mformore/4-20_transmitter/README.md

# 4-20mA and 0-10V Arduino Shield Transmitter
