mformore/4-20_transmitter/BOM/bom-integrated.ods

Sheet: tme
symbol klienta | Symbol | Oznaczenie producenta | Producent | Ilość | Jednostka | Cena brutto | Wartość brutto | Waluta
 | CL21C101JBANNNC | CL21C101JBANNNC | SAMSUNG | 100 | szt | 0.08288 | 8.288 | PLN
 | DG300-5.0-2P12 | DG300-5.0-02P-12-00A(H) | DEGSON ELECTRONICS | 10 | szt | 0.7287 | 7.287 | PLN
 | HP05-1K1% | HP05W3F1001T5E | ROYAL OHM | 50 | szt | 0.19454 | 9.727 | PLN
 | MCP4922-E/SL | MCP4922-E/SL | MICROCHIP TECHNOLOGY | 3 | szt | 12.3369 | 37.0107 | PLN
 | BCP5116TA | BCP5116TA | DIODES INCORPORATED | 10 | szt | 0.50355 | 5.0355 | PLN
 | BC848AE6327 | BC848AE6327 | INFINEON TECHNOLOGIES | 25 | szt | 0.107 | 2.675 | PLN
 | TL072CD | TL072CD | TEXAS INSTRUMENTS | 10 | szt | 2.4729 | 24.729 | PLN
 | BZD27C3V6P-E3-08 | BZD27C3V6P-E3-08 | VISHAY | 10 | szt | 0.59272 | 5.9272 | PLN
 | SMD2010-100R-1% | 2010W2F1000T4E | ROYAL OHM | 10 | szt | 0.46633 | 4.6633 | PLN
 | IFX91041EJV50 | IFX91041EJV50 | INFINEON TECHNOLOGIES | 3 | szt | 6.027 | 18.081 | PLN
 | DJNR5040-470-S | DJNR5040-470-S | FERROCORE | 6 | szt | 0.9232 | 5.5392 | PLN
 | 1N5333BG | 1N5333BG | ON SEMICONDUCTOR | 5 | szt | 1.0438 | 5.219 | PLN
 | 11-21SURC/S530-A2 | 11-21SURC/S530-A2/TR8 | EVERLIGHT | 10 | szt | 0.58747 | 5.8747 | PLN
 | 15-21UYC/S530-A2 | 15-21UYC/S530-A2/TR8 | EVERLIGHT | 10 | szt | 0.6819 | 6.819 | PLN
 | CL21B224KBFNNNE | CL21B224KBFNNNE | SAMSUNG | 100 | szt | 0.08918 | 8.918 | PLN
 | SMD0805-22K-1% | 0805S8F2202T5E | ROYAL OHM | 100 | szt | 0.07721 | 7.721 | PLN
 | IFX91041EJV33 | IFX91041EJV33XUMA1 | INFINEON TECHNOLOGIES | 2 | szt | 5.0307 | 10.0614 | PLN
 | SC1H106M6L005VR | SC1H106M6L005VR | SAMWHA | 25 | szt | 0.30738 | 7.6845 | PLN
 | SC1C107M6L005VR | SC1C107M6L005VR | SAMWHA | 25 | szt | 0.17467 | 4.36675 | PLN
 | SYS1530-1224-W2E | SYS1530-1224-W2E | SUNNY | 1 | szt | 36.9 | 36.9 | PLN
 | NEB21R | NEB 21 R | LUMBERG | 1 | szt | 2.597 | 2.597 | PLN
 | SMD0805-2K2-1% | 0805S8F2201T5E | ROYAL OHM | 100 | szt | 0.07721 | 7.721 | PLN
 | T910W-2K | T910W-2K | SR PASSIVES | 10 | szt | 1.4932 | 14.932 | PLN
 | CL21B104KBCNNNC | CL21B104KBCNNNC | SAMSUNG | 100 | szt | 0.08392 | 8.392 | PLN
 | AL1A-DIO | AL1A | DIOTEC SEMICONDUCTOR | 5 | szt | 0.61895 | 3.09475 | PLN
 | BZX384-B4V7.115 | BZX384-B4V7.115 | NEXPERIA | 20 | szt | 0.1542 | 3.084 | PLN
 | MOF1WS-100K | MOF1WS-100K | SR PASSIVES | 20 | szt | 0.17899 | 3.5798 | PLN
 | RC0805JR-0710K | RC0805JR-0710KL | YAGEO | 100 | szt | 0.0577 | 5.77 | PLN
 | SMD0805-3K | 0805S8J0302T5E | ROYAL OHM | 100 | szt | 0.0683 | 6.83 | PLN
 | SMD0805-1K | 0805S8J0102T5E | ROYAL OHM | 100 | szt | 0.06735 | 6.735 | PLN
 | CRCW080510K0FKTABC | CRCW080510K0FKTABC | VISHAY | 100 | szt | 0.06871 | 6.871 | PLN
 | SMD1206-100K | 1206S4J0104T5E | ROYAL OHM | 100 | szt | 0.06547 | 6.547 | PLN
 | 1SMB5913BT3G | 1SMB5913BT3G | ON SEMICONDUCTOR | 5 | szt | 0.5702 | 2.851 | PLN
 | SS16A-YAN | SS16A | YANGJIE TECHNOLOGY | 20 | szt | 0.14366 | 2.8732 | PLN
 | SMD0805-9K1-1% | 0805S8F9101T5E | ROYAL OHM | 100 | szt | 0.0424 | 4.24 | PLN
 | CL21B223KBANNNC | CL21B223KBANNNC | SAMSUNG | 100 | szt | 0.08341 | 8.341 | PLN

Sheet: kicad
Source: | /home/maciej/Desktop/420-transmitter/420-transmitter/PCB/420-transmitter/420-transmitter.sch
Date: | pon, 29 lip 2019, 13:12:20
Tool: | Eeschema 5.1.2-f72e74a~84~ubuntu19.04.1
Generator: | /usr/share/kicad/plugins/bom_csv_grouped_by_value_with_fp.py
Component Count: | 112
Ref | Qnty | Value | Cmp name | Footprint | Description | Vendor | Part number
C2, | 1 | 10u | CP | Capacitor_SMD:CP_Elec_6.3x5.3 | Polarized capacitor |  | SC1H106M6L005VR
C4, C5, C10, C3, C1, C11, C9, | 7 | 100n | C | Capacitor_SMD:C_0805_2012Metric | Unpolarized capacitor |  | CL21B104KBCNNNC
C6, | 1 | 22n | C | Capacitor_SMD:C_0805_2012Metric | Unpolarized capacitor |  | CL21B223KBANNNC
C7, C12, | 2 | 220nF | C | Capacitor_SMD:C_0805_2012Metric | Unpolarized capacitor |  | CL21B224KBFNNNE
C8, | 1 | 100uF | CP | Capacitor_SMD:CP_Elec_6.3x5.3 | Polarized capacitor |  | SC1C107M6L005VR
C13, C15, C14, C16, | 4 | 100p | C | Capacitor_SMD:C_0805_2012Metric | Unpolarized capacitor |  | CL21C101JBANNNC
D1, D3, | 2 | AL1A | D | Diode_SMD:D_MiniMELF | Diode |  | AL1A
D2, | 1 | 1SMB5913BT3G | D_Zener | Diode_SMD:D_SMB | Zener diode |  | 1SMB5913BT3G
D4, | 1 | SS16A | D_Schottky | Diode_SMD:D_SMA | Schottky diode |  | SS16A
D6, D5, | 2 | BZD27C3V6P-E3-08 | D_Zener | Diode_SMD:D_SOD-123 | Zener diode |  | BZD27C3V6P-E3-08
D7, D8, | 2 | BZX384-B4V7.115 | BZX384-B4V7.115-Diode_custom-420-transmitter-rescue | Diode_SMD:D_SOD-323 |  |  | BZX384-B4V7.115
H1, H5, H7, H2, H4, H6, H8, H9, H3, | 9 | TP1 | MountingHole_Pad | TestPoint:TestPoint_THTPad_D1.0mm_Drill0.5mm | Mounting Hole with connection |  | -
J1, J5, | 2 | Conn_01x08 | Conn_01x08 | Connector_PinSocket_2.54mm:PinSocket_1x08_P2.54mm_Vertical | Generic connector, single row, 01x08, script generated (kicad-library-utils/schlib/autogen/connector/) |  | -
J2, | 1 | Conn_01x06 | Conn_01x06 | m_connectors:PinSocket_1x06_P2.54mm_Vertical_w_Arduino | Generic connector, single row, 01x06, script generated (kicad-library-utils/schlib/autogen/connector/) |  | -
J4, | 1 | Conn_01x10 | Conn_01x10 | Connector_PinSocket_2.54mm:PinSocket_1x10_P2.54mm_Vertical | Generic connector, single row, 01x10, script generated (kicad-library-utils/schlib/autogen/connector/) |  | -
J6, | 1 | 4-20mA_loop1 | Screw_Terminal_01x02 | m_connectors:TerminalBlock_bornier-2_P5.08mm | Generic screw terminal, single row, 01x02, script generated (kicad-library-utils/schlib/autogen/connector/) |  | DG300-5.0-02P-12-00A(H)
J7, | 1 | 4-20mA_loop2 | Screw_Terminal_01x02 | m_connectors:TerminalBlock_bornier-2_P5.08mm | Generic screw terminal, single row, 01x02, script generated (kicad-library-utils/schlib/autogen/connector/) |  | DG300-5.0-02P-12-00A(H)
J8, | 1 | 0-10V_Vout1 | Screw_Terminal_01x02 | m_connectors:TerminalBlock_bornier-2_P5.08mm | Generic screw terminal, single row, 01x02, script generated (kicad-library-utils/schlib/autogen/connector/) |  | DG300-5.0-02P-12-00A(H)
J9, | 1 | 0-10V_Vout2 | Screw_Terminal_01x02 | m_connectors:TerminalBlock_bornier-2_P5.08mm | Generic screw terminal, single row, 01x02, script generated (kicad-library-utils/schlib/autogen/connector/) |  | DG300-5.0-02P-12-00A(H)
J10, | 1 | PWR SW | Conn_01x02 | Connector_PinHeader_2.54mm:PinHeader_1x02_P2.54mm_Vertical | Generic connector, single row, 01x02, script generated (kicad-library-utils/schlib/autogen/connector/) |  | -
J33, | 1 | Barrel_Jack_MountingPin | Barrel_Jack_MountingPin | m_connectors:BarrelJack_Wuerth_6941xx301002 | DC Barrel Jack with a mounting pin |  | NEB 21 R
JP1, | 1 | Vin1 | Jumper_NC_Dual | Connector_PinHeader_2.54mm:PinHeader_1x03_P2.54mm_Vertical | Dual jumper, normally closed |  | -
JP2, | 1 | Vin2 | Jumper_NC_Dual | Connector_PinHeader_2.54mm:PinHeader_1x03_P2.54mm_Vertical | Dual jumper, normally closed |  | -
L1, L2, | 2 | 47uH | L | Inductor_SMD:L_Taiyo-Yuden_MD-5050 | Inductor |  | DJNR5040-470-S
LED_Vin1, LED_Vin2, PWR2, PWR1, | 4 | LED | LED | LED_SMD:LED_0805_2012Metric | Light emitting diode |  | 15-21UYC/S530-A2/TR8
Q4, Q2, Q1, Q3, | 4 | BC848AE | BC848 | Package_TO_SOT_SMD:SOT-23 | 0.1A Ic, 30V Vce, NPN Transistor, SOT-23 |  | BC848AE6327
Q5, Q6, | 2 | BCP5116TA | Q_PNP_BCEC | Package_TO_SOT_SMD:SOT-223 | PNP transistor, base/collector/emitter, collector connected to mounting plane |  | BCP5116TA
R1, | 1 | 100k | R | Resistor_SMD:R_1206_3216Metric | Resistor |  | 1206S4J0104T5E
R3, | 1 | 3k | R | Resistor_SMD:R_0805_2012Metric | Resistor |  | 0805S8J0302T5E
R4, R5, R6, R46, | 4 | 1k | R | Resistor_SMD:R_0805_2012Metric | Resistor |  | 0805S8J0102T5E
R7, | 1 | 22k | R | Resistor_SMD:R_0805_2012Metric | Resistor |  | 0805S8F2202T5E
R8, R9, | 2 | 100 | R | Resistor_SMD:R_0805_2012Metric | Resistor |  | 2010W2F1000T4E
R12, R22, R10, R13, R23, R11, R2, | 7 | 10k | R | Resistor_SMD:R_0805_2012Metric | Resistor |  | RC0805JR-0710KL
R14, R28, R26, R16, R29, R27, | 6 | 1k 1% | R | Resistor_SMD:R_0805_2012Metric | Resistor |  | 0805S8F9101T5E
R15, R17, | 2 | 2,2k 1% | R | Resistor_SMD:R_0805_2012Metric | Resistor |  | 0805S8F2201T5E
R18, R19, | 2 | 10k 1% | R | Resistor_SMD:R_0805_2012Metric | Resistor |  | CRCW080510K0FKTABC
R20, R21, | 2 | 9,1k 1% | R | Resistor_SMD:R_0805_2012Metric | Resistor |  | 0805S8F9101T5E
R24, R25, | 2 | 100 1% | R | Resistor_SMD:R_2010_5025Metric | Resistor |  | 2010W2F1000T4E
R30, R32, R31, R33, R34, R36, R35, R37, R40, R38, R41, R39, R44, R42, R45, R43, | 16 | adj | R | Resistor_SMD:R_0805_2012Metric | Resistor |  | -
RV3, RV1, RV2, RV4, | 4 | 2k | R_POT_TRIM | Potentiometer_THT:Potentiometer_Bourns_3296W_Vertical | Trim-potentiometer |  | T910W-2K
U2, U4, U5, | 3 | TL072 | TL072 | Package_SO:SO-8_5.3x6.2mm_P1.27mm | Dual Low-Noise JFET-Input Operational Amplifiers, DIP-8/SOIC-8 |  | TL072CD
U3, | 1 | MCP4922 | MCP4922 | m_integrated_circuits:SO14 | 2-Channel 12-Bit D/A Converters with SPI Interface |  | MCP4922-E/SL
U6, | 1 | IFX91041EJV50 | IFX91041EJV50 | m_integrated_circuits:Infineon_PG-DSO-8-43 |  |  | IFX91041EJV50

Sheet: integrated
Ref | Qnty | Value | Cmp name | Footprint | Description | Vendor | Part number | Cost
C2, | 1 | 10u | CP | Capacitor_SMD:CP_Elec_6.3x5.3 | Polarized capacitor |  | SC1H106M6L005VR | 0.30738
C4, C5, C10, C3, C1, C11, C9, | 7 | 100n | C | Capacitor_SMD:C_0805_2012Metric | Unpolarized capacitor |  | CL21B104KBCNNNC | 0.58744
C6, | 1 | 22n | C | Capacitor_SMD:C_0805_2012Metric | Unpolarized capacitor |  | CL21B223KBANNNC | 0.08341 |  |  | sum= | 51.76532
C7, C12, | 2 | 220nF | C | Capacitor_SMD:C_0805_2012Metric | Unpolarized capacitor |  | CL21B224KBFNNNE | 0.17836
C8, | 1 | 100uF | CP | Capacitor_SMD:CP_Elec_6.3x5.3 | Polarized capacitor |  | SC1C107M6L005VR | 0.17467
C13, C15, C14, C16, | 4 | 100p | C | Capacitor_SMD:C_0805_2012Metric | Unpolarized capacitor |  | CL21C101JBANNNC | 0.33152
D1, D3, | 2 | AL1A | D | Diode_SMD:D_MiniMELF | Diode |  | AL1A | 1.2379
D2, | 1 | 1SMB5913BT3G | D_Zener | Diode_SMD:D_SMB | Zener diode |  | 1SMB5913BT3G | 0.5702
D4, | 1 | SS16A | D_Schottky | Diode_SMD:D_SMA | Schottky diode |  | SS16A | 0.14366
D6, D5, | 2 | BZD27C3V6P-E3-08 | D_Zener | Diode_SMD:D_SOD-123 | Zener diode |  | BZD27C3V6P-E3-08 | 1.18544 | replacement: | ON SEMICONDUCTOR MMSZ5227BT1G
D7, D8, | 2 | BZX384-B4V7.115 | BZX384-B4V7.115-Diode_custom-420-transmitter-rescue | Diode_SMD:D_SOD-323 |  |  | BZX384-B4V7.115 | 0.3084
H1, H5, H7, H2, H4, H6, H8, H9, H3, | 9 | TP1 | MountingHole_Pad | TestPoint:TestPoint_THTPad_D1.0mm_Drill0.5mm | Mounting Hole with connection |  | - | 0
J1, J5, | 2 | Conn_01x08 | Conn_01x08 | Connector_PinSocket_2.54mm:PinSocket_1x08_P2.54mm_Vertical | Generic connector, single row, 01x08, script generated (kicad-library-utils/schlib/autogen/connector/) |  | - | 0
J2, | 1 | Conn_01x06 | Conn_01x06 | m_connectors:PinSocket_1x06_P2.54mm_Vertical_w_Arduino | Generic connector, single row, 01x06, script generated (kicad-library-utils/schlib/autogen/connector/) |  | - | 0
J4, | 1 | Conn_01x10 | Conn_01x10 | Connector_PinSocket_2.54mm:PinSocket_1x10_P2.54mm_Vertical | Generic connector, single row, 01x10, script generated (kicad-library-utils/schlib/autogen/connector/) |  | - | 0
J6, | 1 | 4-20mA_loop1 | Screw_Terminal_01x02 | m_connectors:TerminalBlock_bornier-2_P5.08mm | Generic screw terminal, single row, 01x02, script generated (kicad-library-utils/schlib/autogen/connector/) |  | DG300-5.0-02P-12-00A(H) | 0.7287
J7, | 1 | 4-20mA_loop2 | Screw_Terminal_01x02 | m_connectors:TerminalBlock_bornier-2_P5.08mm | Generic screw terminal, single row, 01x02, script generated (kicad-library-utils/schlib/autogen/connector/) |  | DG300-5.0-02P-12-00A(H) | 0.7287
J8, | 1 | 0-10V_Vout1 | Screw_Terminal_01x02 | m_connectors:TerminalBlock_bornier-2_P5.08mm | Generic screw terminal, single row, 01x02, script generated (kicad-library-utils/schlib/autogen/connector/) |  | DG300-5.0-02P-12-00A(H) | 0.7287
J9, | 1 | 0-10V_Vout2 | Screw_Terminal_01x02 | m_connectors:TerminalBlock_bornier-2_P5.08mm | Generic screw terminal, single row, 01x02, script generated (kicad-library-utils/schlib/autogen/connector/) |  | DG300-5.0-02P-12-00A(H) | 0.7287
J10, | 1 | PWR SW | Conn_01x02 | Connector_PinHeader_2.54mm:PinHeader_1x02_P2.54mm_Vertical | Generic connector, single row, 01x02, script generated (kicad-library-utils/schlib/autogen/connector/) |  | - | 0
J33, | 1 | Barrel_Jack_MountingPin | Barrel_Jack_MountingPin | m_connectors:BarrelJack_Wuerth_6941xx301002 | DC Barrel Jack with a mounting pin |  | NEB 21 R | 2.597
JP1, | 1 | Vin1 | Jumper_NC_Dual | Connector_PinHeader_2.54mm:PinHeader_1x03_P2.54mm_Vertical | Dual jumper, normally closed |  | - | 0
JP2, | 1 | Vin2 | Jumper_NC_Dual | Connector_PinHeader_2.54mm:PinHeader_1x03_P2.54mm_Vertical | Dual jumper, normally closed |  | - | 0
L1, L2, | 2 | 47uH | L | Inductor_SMD:L_Taiyo-Yuden_MD-5050 | Inductor |  | DJNR5040-470-S | 1.8464
LED_Vin1, LED_Vin2, PWR2, PWR1, | 4 | LED | LED | LED_SMD:LED_0805_2012Metric | Light emitting diode |  | 15-21UYC/S530-A2/TR8 | 2.7276
Q4, Q2, Q1, Q3, | 4 | BC848AE | BC848 | Package_TO_SOT_SMD:SOT-23 | 0.1A Ic, 30V Vce, NPN Transistor, SOT-23 |  | BC848AE6327 | 0.428
Q5, Q6, | 2 | BCP5116TA | Q_PNP_BCEC | Package_TO_SOT_SMD:SOT-223 | PNP transistor, base/collector/emitter, collector connected to mounting plane |  | BCP5116TA | 1.0071
R1, | 1 | 100k | R | Resistor_SMD:R_1206_3216Metric | Resistor |  | 1206S4J0104T5E | 0.06547
R3, | 1 | 3k | R | Resistor_SMD:R_0805_2012Metric | Resistor |  | 0805S8J0302T5E | 0.0683
R4, R5, R6, R46, | 4 | 1k | R | Resistor_SMD:R_0805_2012Metric | Resistor |  | 0805S8J0102T5E | 0.2694
R7, | 1 | 22k | R | Resistor_SMD:R_0805_2012Metric | Resistor |  | 0805S8F2202T5E | 0.07721
R8, R9, | 2 | 100 | R | Resistor_SMD:R_0805_2012Metric | Resistor |  | 2010W2F1000T4E | 0.93266
R12, R22, R10, R13, R23, R11, R2, | 7 | 10k | R | Resistor_SMD:R_0805_2012Metric | Resistor |  | RC0805JR-0710KL | 0.4039
R14, R28, R26, R16, R29, R27, | 6 | 1k 1% | R | Resistor_SMD:R_0805_2012Metric | Resistor |  | 0805S8F9101T5E | 0.2544
R15, R17, | 2 | 2,2k 1% | R | Resistor_SMD:R_0805_2012Metric | Resistor |  | 0805S8F2201T5E | 0.15442
R18, R19, | 2 | 10k 1% | R | Resistor_SMD:R_0805_2012Metric | Resistor |  | CRCW080510K0FKTABC | 0.13742
R20, R21, | 2 | 9,1k 1% | R | Resistor_SMD:R_0805_2012Metric | Resistor |  | 0805S8F9101T5E | 0.0848
R24, R25, | 2 | 100 1% | R | Resistor_SMD:R_2010_5025Metric | Resistor |  | 2010W2F1000T4E | 0.93266
R30, R32, R31, R33, R34, R36, R35, R37, R40, R38, R41, R39, R44, R42, R45, R43, | 16 | adj | R | Resistor_SMD:R_0805_2012Metric | Resistor |  | - | 0
RV3, RV1, RV2, RV4, | 4 | 2k | R_POT_TRIM | Potentiometer_THT:Potentiometer_Bourns_3296W_Vertical | Trim-potentiometer |  | T910W-2K | 5.9728
U2, U4, U5, | 3 | TL072 | TL072 | Package_SO:SO-8_5.3x6.2mm_P1.27mm | Dual Low-Noise JFET-Input Operational Amplifiers, DIP-8/SOIC-8 |  | TL072CD | 7.4187
U3, | 1 | MCP4922 | MCP4922 | m_integrated_circuits:SO14 | 2-Channel 12-Bit D/A Converters with SPI Interface |  | MCP4922-E/SL | 12.3369
U6, | 1 | IFX91041EJV50 | IFX91041EJV50 | m_integrated_circuits:Infineon_PG-DSO-8-43 |  |  | IFX91041EJV50 | 6.027

Sheet: Dokumentacja
Symbol | Ilość | Wartość | Obudowa | Opis | Numer części (TME) | Koszt
C2, | 1 | 10u | 6.3x5.3mm | Kondensator ceramiczny | SC1H106M6L005VR | 0.30738
C4, C5, C10, C3, C1, C11, C9, | 7 | 100n | 0805 | Kondensator ceramiczny | CL21B104KBCNNNC | 0.58744
C6, | 1 | 22n | 0805 | Kondensator ceramiczny | CL21B223KBANNNC | 0.08341 |  |  | sum= | 51.76532
C7, C12, | 2 | 220nF | 0805 | Kondensator ceramiczny | CL21B224KBFNNNE | 0.17836
C8, | 1 | 100uF | 6.3x5.3mm | Kondensator elektrolityczny | SC1C107M6L005VR | 0.17467
C13, C15, C14, C16, | 4 | 100p | 0805 | Kondensator ceramiczny | CL21C101JBANNNC | 0.33152
D1, D3, | 2 | 1A; max 50V | MiniMELF | Dioda prostownicza | AL1A | 1.2379
D2, | 1 | 3,3V | SMB | Dioda Zenera | 1SMB5913BT3G | 0.5702
D4, | 1 | 60V | SMA | Dioda Schottky’ego | SS16A | 0.14366
D6, D5, | 2 | 3,6V | SOD-123 | Dioda Zenera | BZD27C3V6P-E3-08 | 1.18544 | replacement: | ON SEMICONDUCTOR MMSZ5227BT1G
D7, D8, | 2 | 4,7V | SOD-323 | Dioda Zenera | BZX384-B4V7.115 | 0.3084
J1, J5, | 2 | - | Raster 2,54mm 1x8 | Listwa goldpin żeńska | - | 0
J2, | 1 | - | Raster 2,54mm 1x6 | Listwa goldpin żeńska | - | 0
J4, | 1 | - | Raster 2,54mm 1x10 | Listwa goldpin żeńska | - | 0
J6, | 1 | - | Raster 5.08mm x2 | Złącze zaciskowe | DG300-5.0-02P-12-00A(H) | 0.7287
J7, | 1 | - | Raster 5.08mm 1x2 | Złącze zaciskowe | DG300-5.0-02P-12-00A(H) | 0.7287
J8, | 1 | - | Raster 5.08mm 1x2 | Złącze zaciskowe | DG300-5.0-02P-12-00A(H) | 0.7287
J9, | 1 | - | Raster 5.08mm 1x2 | Złącze zaciskowe | DG300-5.0-02P-12-00A(H) | 0.7287
J10, | 1 | - | Raster 2,54mm 1x2 | Listwa goldpin męska | - | 0
J33, | 1 | - | Wuerth_6941xx301002 | Gniazdo DC okrągłe | NEB 21 R | 2.597
JP1, | 1 | - | Raster 2,54mm 1x3 | Listwa goldpin męska | - | 0
JP2, | 1 | - | Raster 2,54mm 1x3 | Listwa goldpin męska | - | 0
L1, L2, | 2 | 47uH | Taiyo-Yuden_MD-5050 | Cewka | DJNR5040-470-S | 1.8464
LED_Vin1, LED_Vin2, PWR2, PWR1, | 4 | - | 1206 | LED | 15-21UYC/S530-A2/TR8 | 2.7276
Q4, Q2, Q1, Q3, | 4 | 30V; 0,1A; 0,3W | SOT-23 | Tranzystor NPN | BC848AE6327 | 0.428
Q5, Q6, | 2 | 45V; 1A; 2W | SOT-223 | Tranzystor PNP | BCP5116TA | 1.0071
R1, | 1 | 100k | 1206 | Rezystor | 1206S4J0104T5E | 0.06547
R3, | 1 | 3k | 0805 | Rezystor | 0805S8J0302T5E | 0.0683
R4, R5, R6, R46, | 4 | 1k | 0805 | Rezystor | 0805S8J0102T5E | 0.2694
R7, | 1 | 22k | 0805 | Rezystor | 0805S8F2202T5E | 0.07721
R8, R9, | 2 | 100 | 0805 | Rezystor | 2010W2F1000T4E | 0.93266
R12, R22, R10, R13, R23, R11, R2, | 7 | 10k | 0805 | Rezystor | RC0805JR-0710KL | 0.4039
R14, R28, R26, R16, R29, R27, | 6 | 1k 1% | 0805 | Rezystor | 0805S8F9101T5E | 0.2544
R15, R17, | 2 | 2,2k 1% | 0805 | Rezystor | 0805S8F2201T5E | 0.15442
R18, R19, | 2 | 10k 1% | 0805 | Rezystor | CRCW080510K0FKTABC | 0.13742
R20, R21, | 2 | 9,1k 1% | 0805 | Rezystor | 0805S8F9101T5E | 0.0848
R24, R25, | 2 | 100 1% | 2010 | Rezystor | 2010W2F1000T4E | 0.93266
RV3, RV1, RV2, RV4, | 4 | 2k | Bourns_3296W_Vertical | Potencjometr montażowy | T910W-2K | 5.9728
U2, U4, U5, | 3 | -15/+15V | DIP-8/SOIC-8 | Wzmacniacz operacyjny | TL072CD | 7.4187
U3, | 1 | 14bit; SPI | SO14 | Przetwornik DAC | MCP4922-E/SL | 12.3369
U6, | 1 | +5V; 1,8A | Infineon_PG-DSO-8-43 | Przetwornica step-down | IFX91041EJV50 | 6.027
 | 75

Sheet: pivot-table
l.p. | Symbol | Oznaczenie producenta | Producent | Ilość | Jednostka | Cena brutto | Wartość brutto | Waluta | (empty)
1 | CL21C101JBANNNC | CL21C101JBANNNC | SAMSUNG | 100 | szt | 0.08288 | 8.288 | PLN
2 | C0805C223K5RACAUTO | C0805C223K5RACAUTO | KEMET | 10 | szt | 0.29216 | 2.9216 | PLN
3 | DG300-5.0-2P12 | DG300-5.0-02P-12-00A(H) | DEGSON ELECTRONICS | 10 | szt | 0.7287 | 7.287 | PLN
4 | HP05-1K1% | HP05W3F1001T5E | ROYAL OHM | 50 | szt | 0.19454 | 9.727 | PLN
5 | MCP4922-E/SL | MCP4922-E/SL | MICROCHIP TECHNOLOGY | 3 | szt | 12.3369 | 37.0107 | PLN
6 | BCP5116TA | BCP5116TA | DIODES INCORPORATED | 10 | szt | 0.50355 | 5.0355 | PLN
7 | BC848AE6327 | BC848AE6327 | INFINEON TECHNOLOGIES | 25 | szt | 0.107 | 2.675 | PLN
8 | TL072CD | TL072CD | TEXAS INSTRUMENTS | 10 | szt | 2.4729 | 24.729 | PLN
9 | BZD27C3V6P-E3-08 | BZD27C3V6P-E3-08 | VISHAY | 10 | szt | 0.59272 | 5.9272 | PLN
10 | SMD2010-100R-1% | 2010W2F1000T4E | ROYAL OHM | 10 | szt | 0.46633 | 4.6633 | PLN
11 | IFX91041EJV50 | IFX91041EJV50 | INFINEON TECHNOLOGIES | 3 | szt | 6.027 | 18.081 | PLN
12 | DJNR5040-470-S | DJNR5040-470-S | FERROCORE | 6 | szt | 0.9232 | 5.5392 | PLN
13 | 1N5333BG | 1N5333BG | ON SEMICONDUCTOR | 5 | szt | 1.0438 | 5.219 | PLN
14 | 11-21SURC/S530-A2 | 11-21SURC/S530-A2/TR8 | EVERLIGHT | 10 | szt | 0.58747 | 5.8747 | PLN
15 | 15-21UYC/S530-A2 | 15-21UYC/S530-A2/TR8 | EVERLIGHT | 10 | szt | 0.6819 | 6.819 | PLN
16 | CL21B224KBFNNNE | CL21B224KBFNNNE | SAMSUNG | 100 | szt | 0.08918 | 8.918 | PLN
17 | SMD0805-22K-1% | 0805S8F2202T5E | ROYAL OHM | 100 | szt | 0.07721 | 7.721 | PLN
18 | IFX91041EJV33 | IFX91041EJV33XUMA1 | INFINEON TECHNOLOGIES | 2 | szt | 5.0307 | 10.0614 | PLN
19 | SC1H106M6L005VR | SC1H106M6L005VR | SAMWHA | 25 | szt | 0.30738 | 7.6845 | PLN
20 | SC1C107M6L005VR | SC1C107M6L005VR | SAMWHA | 25 | szt | 0.17467 | 4.36675 | PLN
21 | SYS1530-1224-W2E | SYS1530-1224-W2E | SUNNY | 1 | szt | 36.9 | 36.9 | PLN
22 | NEB21R | NEB 21 R | LUMBERG | 1 | szt | 2.597 | 2.597 | PLN
23 | SMD0805-2K2-1% | 0805S8F2201T5E | ROYAL OHM | 100 | szt | 0.07721 | 7.721 | PLN
24 | T910W-2K | T910W-2K | SR PASSIVES | 10 | szt | 1.4932 | 14.932 | PLN
25 | CL21B104KBCNNNC | CL21B104KBCNNNC | SAMSUNG | 100 | szt | 0.08392 | 8.392 | PLN
26 | AL1A-DIO | AL1A | DIOTEC SEMICONDUCTOR | 5 | szt | 0.61895 | 3.09475 | PLN
27 | BZX384-B4V7.115 | BZX384-B4V7.115 | NEXPERIA | 20 | szt | 0.1542 | 3.084 | PLN
28 | MOF1WS-100K | MOF1WS-100K | SR PASSIVES | 20 | szt | 0.17899 | 3.5798 | PLN
29 | RC0805JR-0710K | RC0805JR-0710KL | YAGEO | 100 | szt | 0.0577 | 5.77 | PLN
30 | SMD0805-3K | 0805S8J0302T5E | ROYAL OHM | 100 | szt | 0.0683 | 6.83 | PLN
31 | SMD0805-1K | 0805S8J0102T5E | ROYAL OHM | 100 | szt | 0.06735 | 6.735 | PLN
32 | CRCW080510K0FKTABC | CRCW080510K0FKTABC | VISHAY | 100 | szt | 0.06871 | 6.871 | PLN
33 | SMD1206-100K | 1206S4J0104T5E | ROYAL OHM | 100 | szt | 0.06547 | 6.547 | PLN
34 | 1SMB5913BT3G | 1SMB5913BT3G | ON SEMICONDUCTOR | 5 | szt | 0.5702 | 2.851 | PLN
35 | SS16A-YAN | SS16A | YANGJIE TECHNOLOGY | 20 | szt | 0.14366 | 2.8732 | PLN
36 | SMD0805-9K1-1% | 0805S8F9101T5E | ROYAL OHM | 100 | szt | 0.0424 | 4.24 | PLN
Total Result
