mformore/4-20_transmitter/PCB/420-transmitter/420-transmitter.pdf

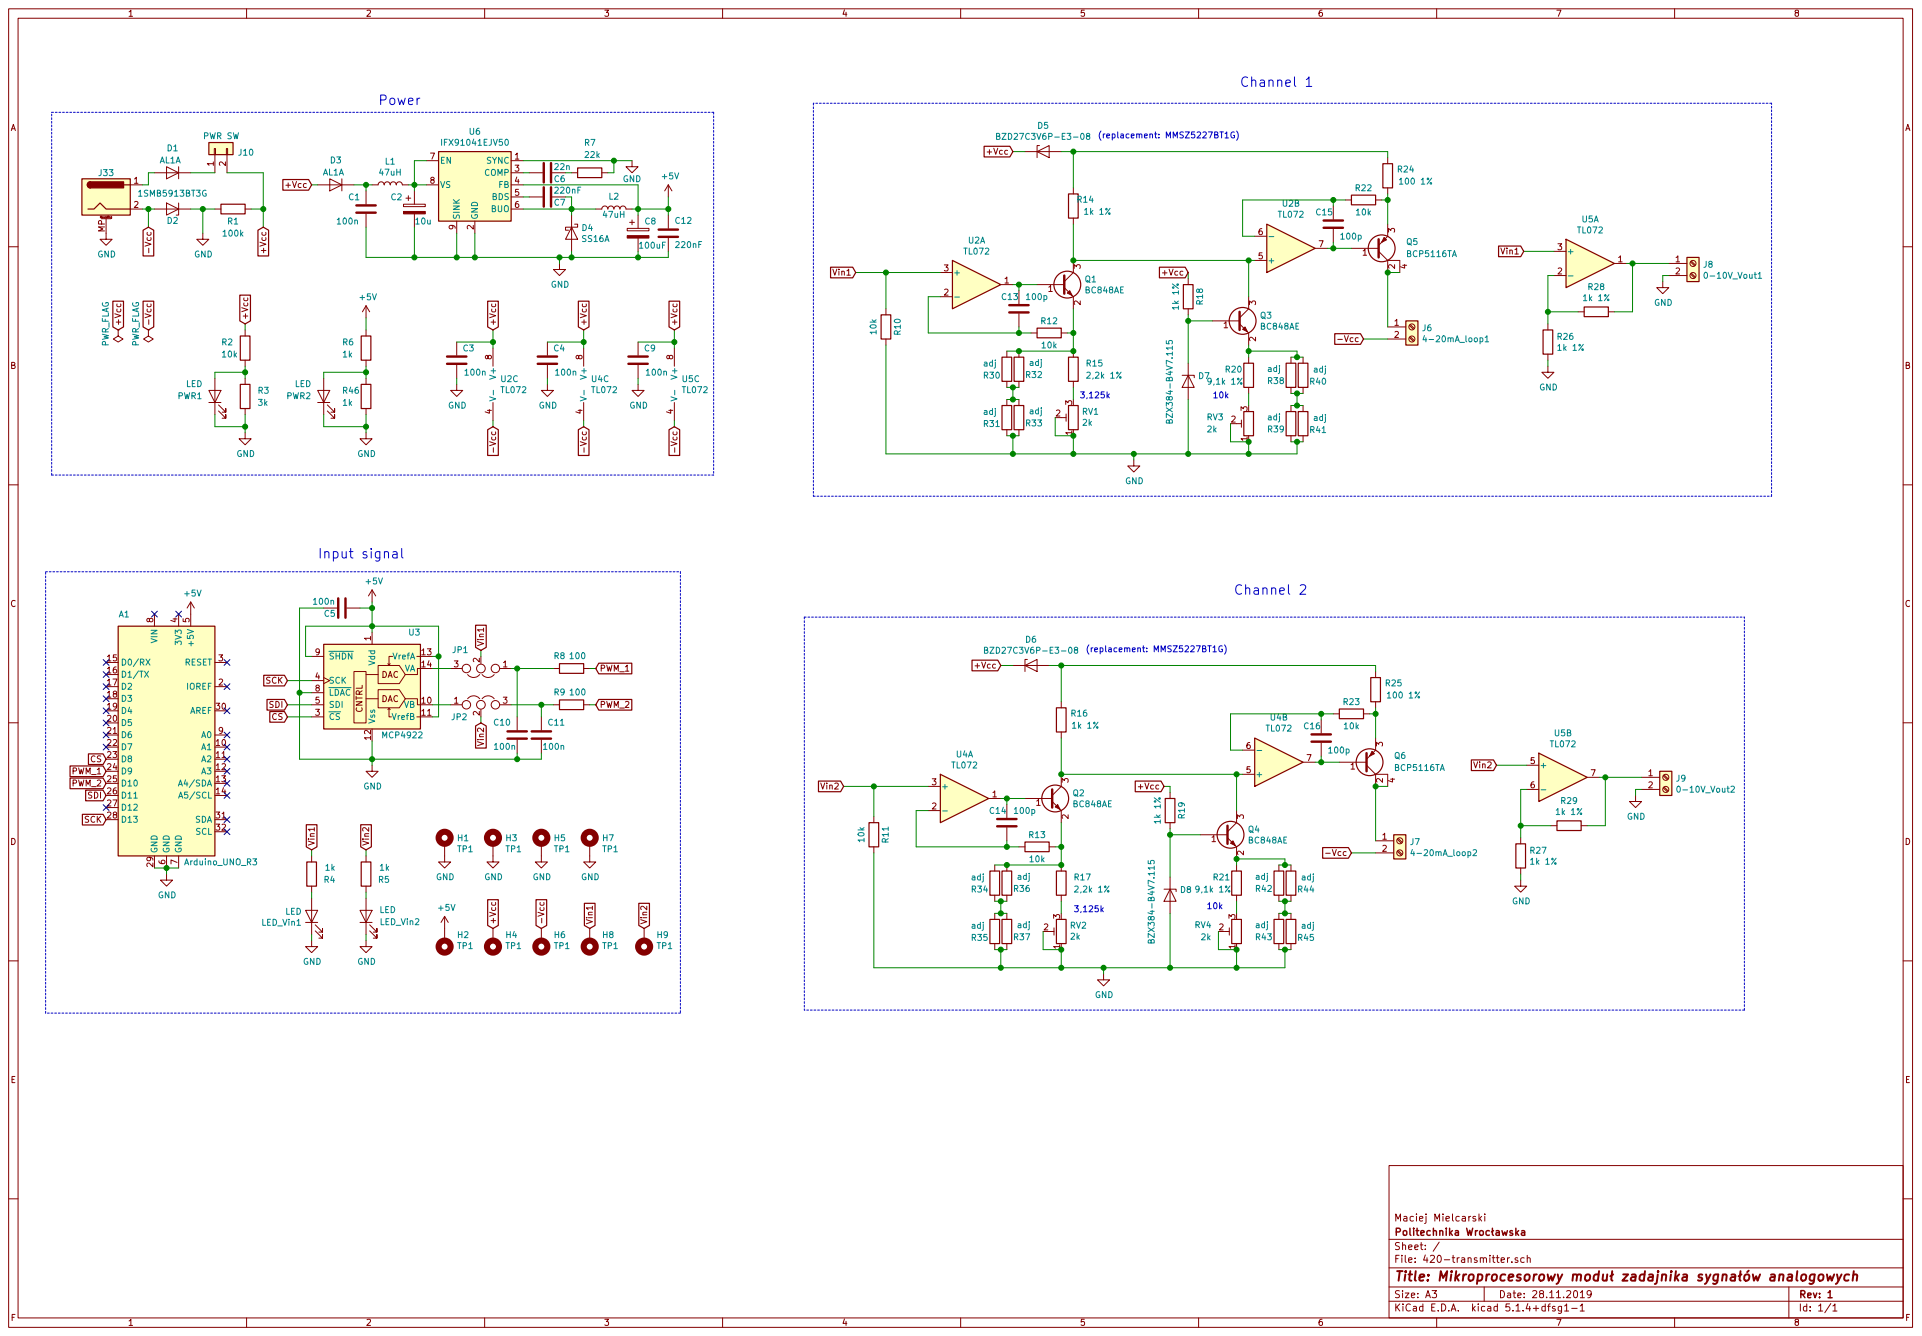
[picture p1: page 1]

2 COMP 3 FB 4 BDS 5 BUO 6 EN 7 VS 8 SINK

1 VB 10 VrefB 11 Vss 12 VrefA 13 VA 14 CS 3 SCK 4 SDI 5

File: 420-transmitter.sch Sheet: / Politechnika Wrocawska Maciej Mielcarski LED_Vin2

Id: 1/1 Title: Mikroprocesorowy modu zadajnika sygnaów analogowych
