mformore/4-20_transmitter/Simulation/420-transmitter-less.asc

D3: zener; 1N750
D4: zener; PH_BZX84C3V3
D6: diode; 1N4148
D8: zener; PH_BZX84C3V3
Q2: pnp; BC557B
Q3: npn; BC847A
Q7: npn; BC847A
R1: res; 10k
R2: res; 100k
R3: res; 1k
R4: res; 3k
R5: res; 100
R6: res; 125
R7: res; 1k
R8: res; 10k
R12: res; 1k
R13: res; 1k
R14: res; 10k
Rload1: res; 200
U6: OP07
U7: TL072
U8: TL072
V2: voltage; 5
V5: voltage; 24
Named nets: +Vcc, 0, Vin, -Vcc, Vout
.dc V5 0 30 0.5
PWM / DAC
;dc V5 17 30 0.5
