mformore/4-20_transmitter/Simulation/420-transmitter.asc

C1: cap; 100p
C2: cap; 100p
D1: zener; PH_BZX84C3V3
D3: zener; 1N750
D4: zener; PH_BZX84C3V3
D5: zener; 1N750
D6: diode; 1N4148
D7: LED; NSCW100
D8: zener; PH_BZX84C3V3
Q2: pnp; BC557B
Q3: npn; BC847A
Q4: npn; BC337-40
Q5: pnp; BC557B
Q6: npn; BC337-40
Q7: npn; BC847A
R1: res; 10k
R2: res; 100k
R3: res; 1k
R4: res; 3k
R5: res; 100
R6: res; 125
R7: res; 1k
R8: res; 10k
R9: res; 100
R10: res; 1k
R11: res; 1k
R12: res; 1k
R13: res; 1k
R14: res; 10k
R15: res; 3k
R16: res; 125
R17: res; 10k
R18: res; 10k
R19: res; 1k
R20: res; 1k
R21: res; 10k
R22: res; 10k
R23: res; 10k
R24: res; 10k
R25: res; 3k
Rload1: res; 200
Rload2: res; 200
U1: OP07
U2: OP07
U3: OP07
U6: OP07
U7: TL072
U8: TL072
V1: voltage; 5
V2: voltage; 1.5V
V3: voltage; 0
V5: voltage; 24
Named nets: +Vcc, 0, Vin, -Vcc, Vout, +5V
.dc V2 0 30 0.1
4-20mA
0-10V
4mA offset
~ +20V
~ -3,3V
PWM / DAC
0.5W
6W
4-20mA
0-10V
0.5W
0.5W
;dc V5 17 30 0.5
