mformore/4-20_transmitter/PCB/420-transmitter/420-transmitter.kicad_pcb

## KiCad design PCB/420-transmitter/420-transmitter.kicad_pcb (2022-08-16)

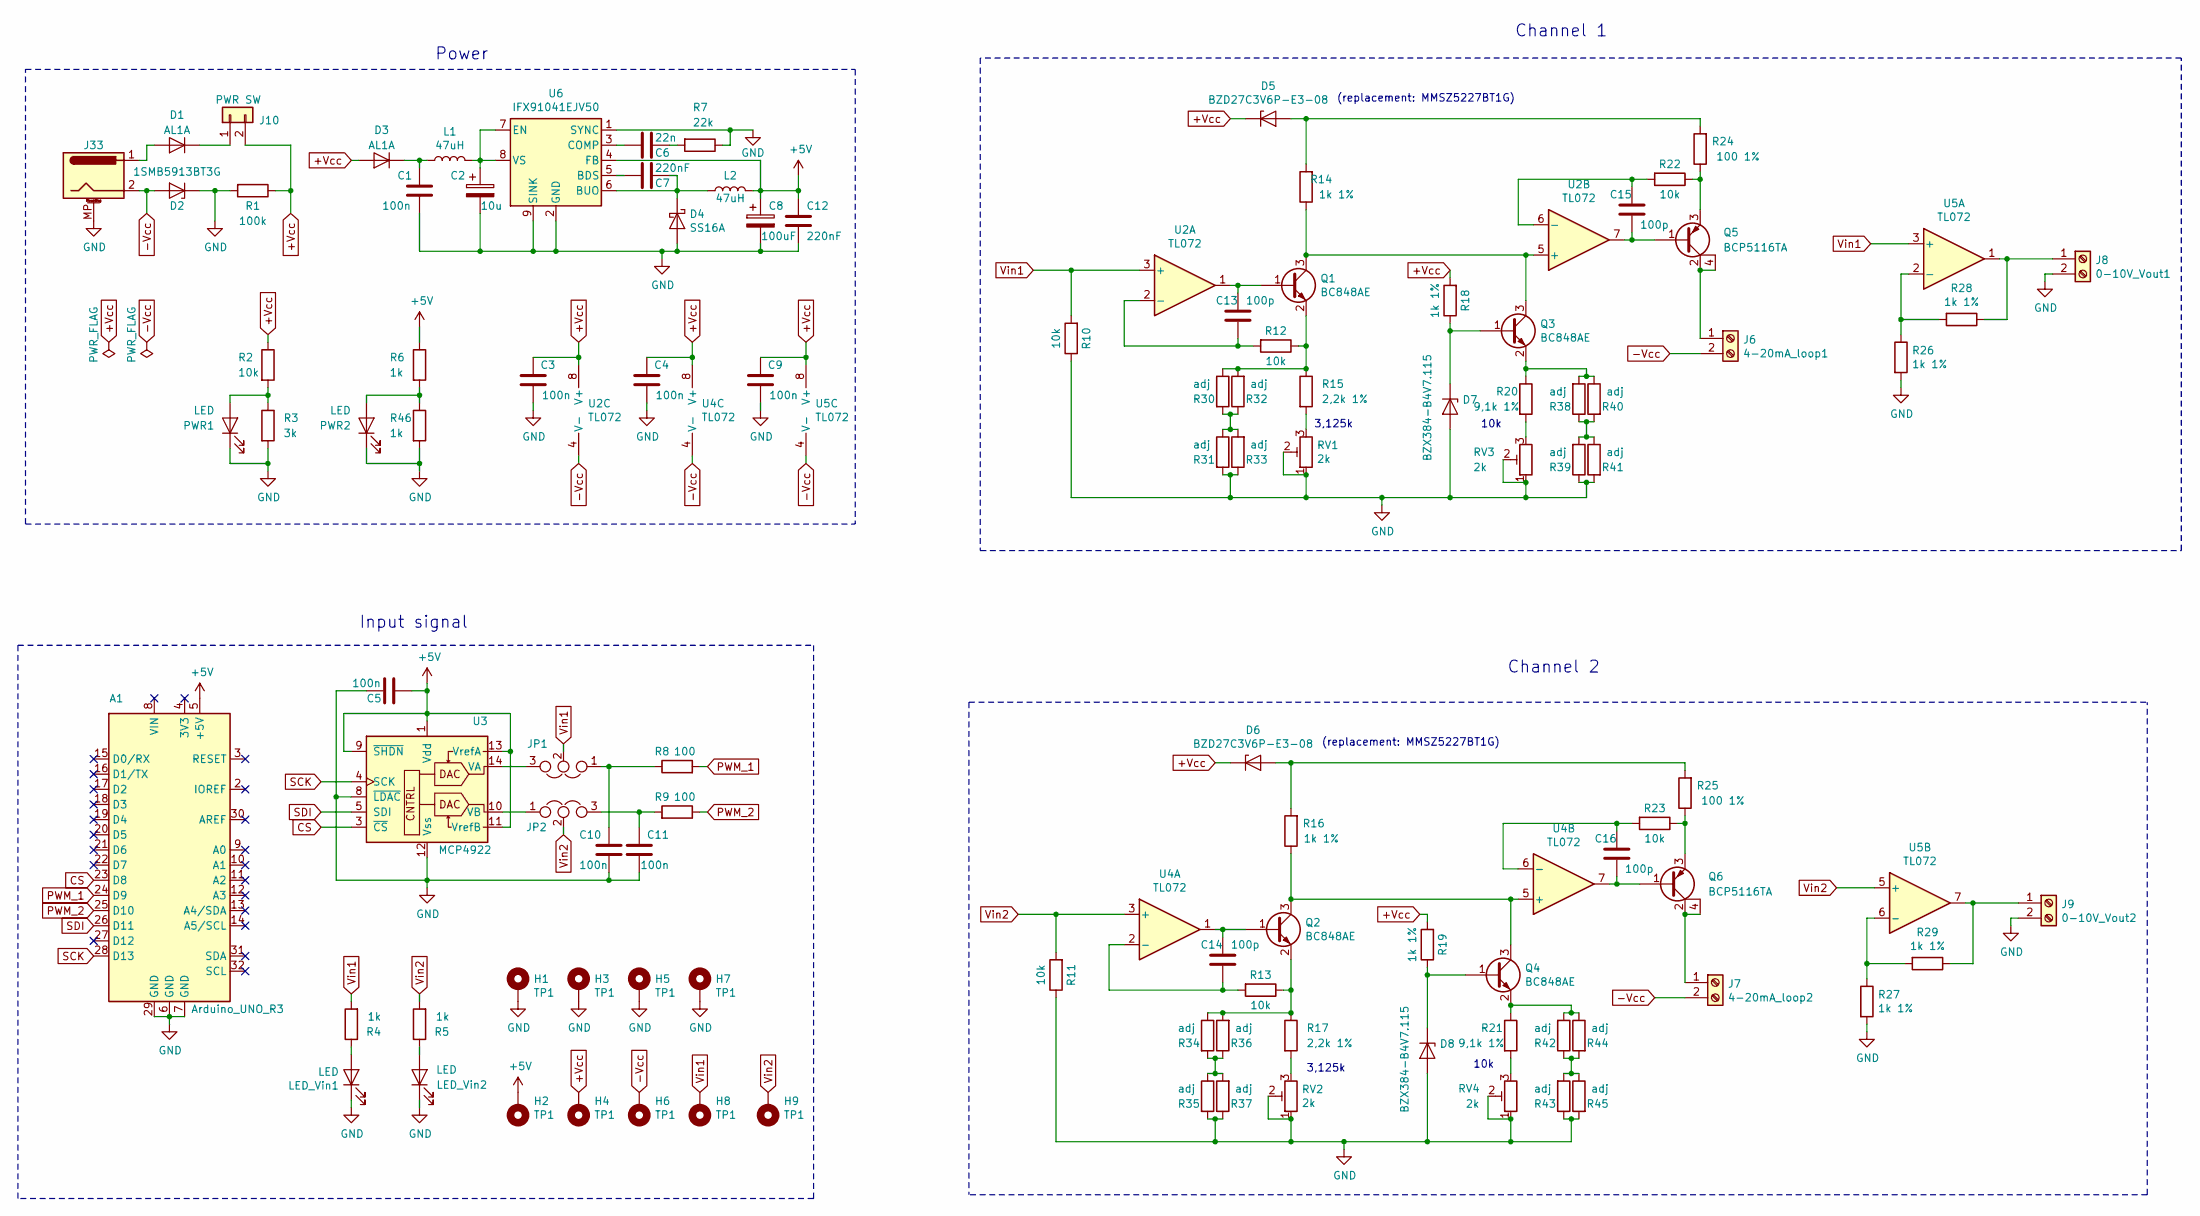
[picture p2: schematic 420-transmitter.sch, Mikroprocesorowy moduł zadajnika sygnałów analogowych]

Parts:
A1: Arduino_UNO_R3
C1, C3, C4, C5, C9, C10, C11: 100n; C_0805_2012Metric
C2: 10u; CP_Elec_6.3x5.3
C6: 22n; C_0805_2012Metric
C7, C12: 220nF; C_0805_2012Metric
C8: 100uF; CP_Elec_6.3x5.3
C13, C14, C15, C16: 100p; C_0805_2012Metric
D1, D3: AL1A; D_MiniMELF
D2: 1SMB5913BT3G; D_SMB
D4: SS16A; D_SMA
D5, D6: BZD27C3V6P-E3-08; D_SOD-123
D7, D8: BZX384-B4V7.115; D_SOD-323
H1, H2, H3, H4, H5, H6, H7, H8, H9: TP1; TestPoint_THTPad_D1.0mm_Drill0.5mm
J6: 4-20mA_loop1; TerminalBlock_bornier-2_P5.08mm
J7: 4-20mA_loop2; TerminalBlock_bornier-2_P5.08mm
J8: 0-10V_Vout1; TerminalBlock_bornier-2_P5.08mm
J9: 0-10V_Vout2; TerminalBlock_bornier-2_P5.08mm
J10: PWR SW; PinHeader_1x02_P2.54mm_Vertical
J33: Barrel_Jack_MountingPin; BarrelJack_Wuerth_6941xx301002
JP1: Vin1; PinHeader_1x03_P2.54mm_Vertical
JP2: Vin2; PinHeader_1x03_P2.54mm_Vertical
L1, L2: 47uH; L_Taiyo-Yuden_MD-5050
LED_Vin1, LED_Vin2: LED; LED_0805_2012Metric
PWR1, PWR2: LED; LED_0805_2012Metric
Q1, Q2, Q3, Q4: BC848AE; SOT-23
Q5, Q6: BCP5116TA; SOT-223
R1: 100k; R_1206_3216Metric
R2, R10, R11, R12, R13, R22, R23: 10k; R_0805_2012Metric
R3: 3k; R_0805_2012Metric
R4, R5, R6, R46: 1k; R_0805_2012Metric
R7: 22k; R_0805_2012Metric
R8, R9: 100; R_0805_2012Metric
R14, R16, R18, R19, R26, R27, R28, R29: 1k 1%; R_0805_2012Metric
R15, R17: 2,2k 1%; R_0805_2012Metric
R20, R21: 9,1k 1%; R_0805_2012Metric
R24, R25: 100 1%; R_2010_5025Metric
R30, R31, R32, R33, R34, R35, R36, R37, R38, R39, R40, R41, R42, R43, R44, R45: adj; R_0805_2012Metric
RV1, RV2, RV3, RV4: 2k; Potentiometer_Bourns_3296W_Vertical
U2, U4, U5: TL072; SO-8_5.3x6.2mm_P1.27mm
U3: MCP4922; SO14
U6: IFX91041EJV50; Infineon_PG-DSO-8-43

Connections:
+5V: A1.5 (+5V), C5.1, C8.1, C12.2, H2.1, L2.2, R6.1, U3.1 (Vdd), U3.9 (~SHDN), U3.11 (VrefB), U3.13 (VrefA), U6.4 (FB)
+Vcc: C3.1, C4.1, C9.1, D3.2 (A), D5.1 (K), D6.1 (K), H4.1, J10.2, R1.1, R2.1, R18.2, R19.2, U2.8 (V+), U4.8 (V+), U5.8 (V+)
-Vcc: D2.2 (A), H6.1, J6.2, J7.2, J33.2, U2.4 (V-), U4.4 (V-), U5.4 (V-)
CS: A1.23 (D8), U3.3 (~CS)
GND: A1.6 (GND), A1.7 (GND), A1.29 (GND), C1.2, C2.2, C3.2, C4.2, C5.2, C8.2, C9.2, C10.1, C11.1, C12.1, D2.1 (K), D4.2 (A), D7.2 (A), D8.2 (A), H1.1, H3.1, H5.1, H7.1, J8.2, J9.2, J33.MP (MountPin), LED_Vin1.1 (K), LED_Vin2.1 (K), PWR1.1 (K), PWR2.1 (K), R1.2, R3.2, R7.1, R10.1, R11.1, R26.2, R27.2, R31.2, R33.1, R35.2, R37.1, R39.1, R41.2, R43.1, R45.2, R46.2, RV1.1, RV1.2, RV2.1, RV2.2, RV3.1, RV3.2, RV4.1, RV4.2, U3.8 (~LDAC), U3.12 (Vss), U6.1 (SYNC), U6.2 (GND), U6.9 (SINK)
unnamed: C1.1, D3.1 (K), L1.1
unnamed: C2.1, L1.2, U6.7 (EN), U6.8 (VS)
unnamed: C6.1, R7.2
unnamed: C6.2, U6.3 (COMP)
unnamed: C7.1, U6.5 (BDS)
unnamed: C7.2, D4.1 (K), L2.1, U6.6 (BUO)
unnamed: C10.2, JP1.1, R8.1
unnamed: C11.2, JP2.3, R9.2
unnamed: C13.1, Q1.1 (B), U2.1
unnamed: C13.2, R12.2, U2.2 (-)
unnamed: C14.1, Q2.1 (B), U4.1
unnamed: C14.2, R13.2, U4.2 (-)
unnamed: C15.1, R22.2, U2.6 (-)
unnamed: C15.2, Q5.1 (B), U2.7
unnamed: C16.1, R23.2, U4.6 (-)
unnamed: C16.2, Q6.1 (B), U4.7
unnamed: D1.1 (K), J10.1
unnamed: D1.2 (A), J33.1
unnamed: D5.2 (A), R14.2, R24.2
unnamed: D6.2 (A), R16.2, R25.2
unnamed: D7.1 (K), Q3.1 (B), R18.1
unnamed: D8.1 (K), Q4.1 (B), R19.1
unnamed: J6.1, Q5.2 (C), Q5.4 (C)
unnamed: J7.1, Q6.2 (C), Q6.4 (C)
unnamed: J8.1, R28.1, U5.1
unnamed: J9.1, R29.1, U5.7
unnamed: JP1.3, U3.14 (VA)
unnamed: JP2.1, U3.10 (VB)
unnamed: LED_Vin1.2 (A), R4.1
unnamed: LED_Vin2.2 (A), R5.1
unnamed: PWR1.2 (A), R2.2, R3.1
unnamed: PWR2.2 (A), R6.2, R46.1
unnamed: Q1.2 (E), R12.1, R15.1, R30.1, R32.2
unnamed: Q1.3 (C), Q3.3 (C), R14.1, U2.5 (+)
unnamed: Q2.2 (E), R13.1, R17.1, R34.1, R36.2
unnamed: Q2.3 (C), Q4.3 (C), R16.1, U4.5 (+)
unnamed: Q3.2 (E), R20.1, R38.2, R40.1
unnamed: Q4.2 (E), R21.1, R42.2, R44.1
unnamed: Q5.3 (E), R22.1, R24.1
unnamed: Q6.3 (E), R23.1, R25.1
unnamed: R15.2, RV1.3
unnamed: R17.2, RV2.3
unnamed: R20.2, RV3.3
unnamed: R21.2, RV4.3
unnamed: R26.1, R28.2, U5.2 (-)
unnamed: R27.1, R29.2, U5.6 (-)
unnamed: R30.2, R31.1, R32.1, R33.2
unnamed: R34.2, R35.1, R36.1, R37.2
unnamed: R38.1, R39.2, R40.2, R41.1
unnamed: R42.1, R43.2, R44.2, R45.1
PWM_1: A1.24 (D9), R8.2
PWM_2: A1.25 (D10), R9.1
SCK: A1.28 (D13), U3.4 (SCK)
SDI: A1.26 (D11), U3.5 (SDI)
Vin1: H8.1, JP1.2, R4.2, R10.2, U2.3 (+), U5.3 (+)
Vin2: H9.1, JP2.2, R5.2, R11.2, U4.3 (+), U5.5 (+)

Notes on the sheet:
Power
Input signal
Channel 1
Channel 2
10k
3,125k
(replacement: MMSZ5227BT1G)

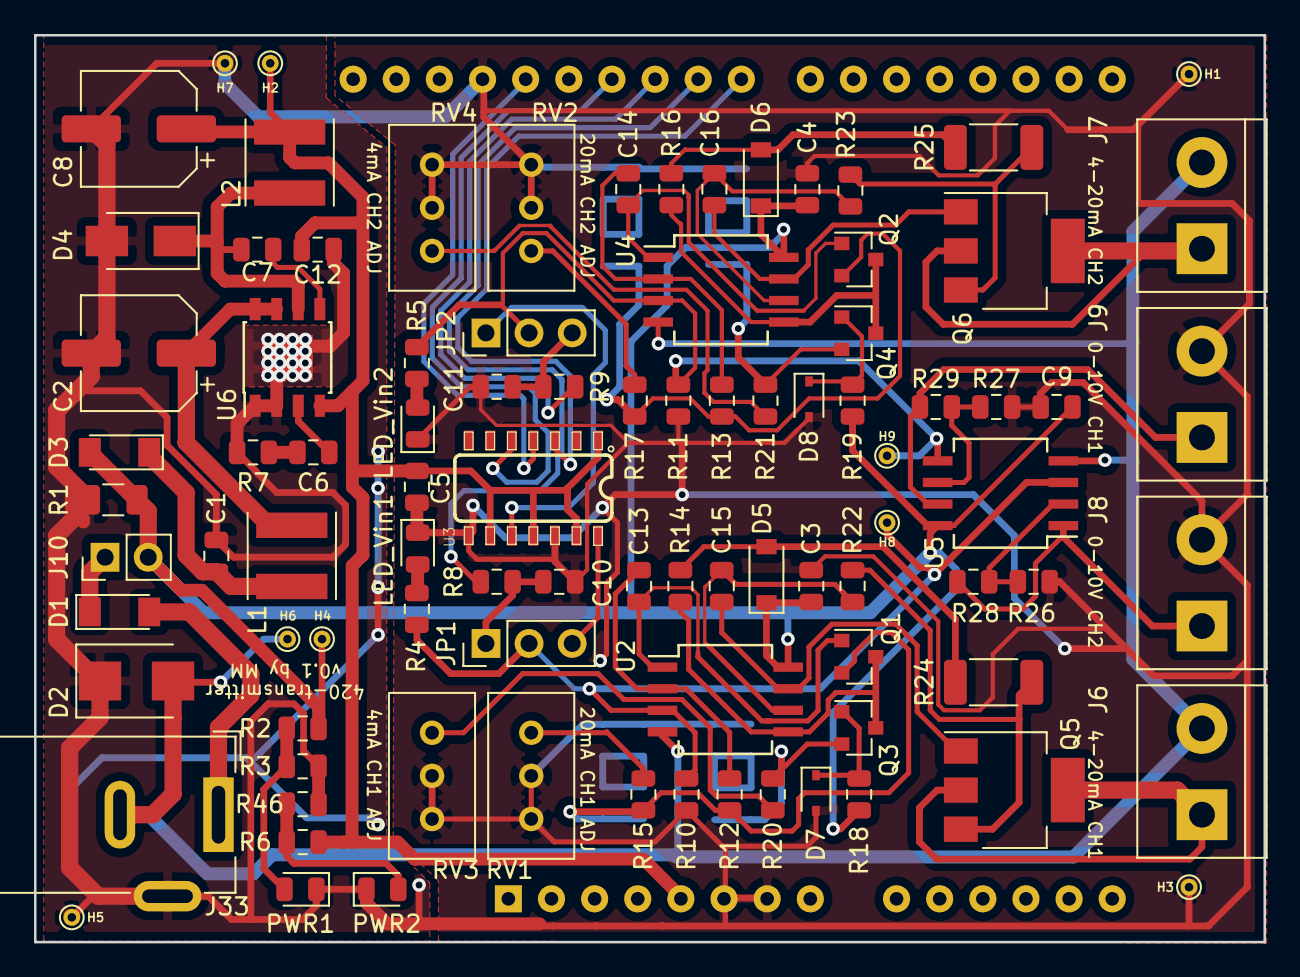
[picture p3: board 420-transmitter.kicad_pcb from above]

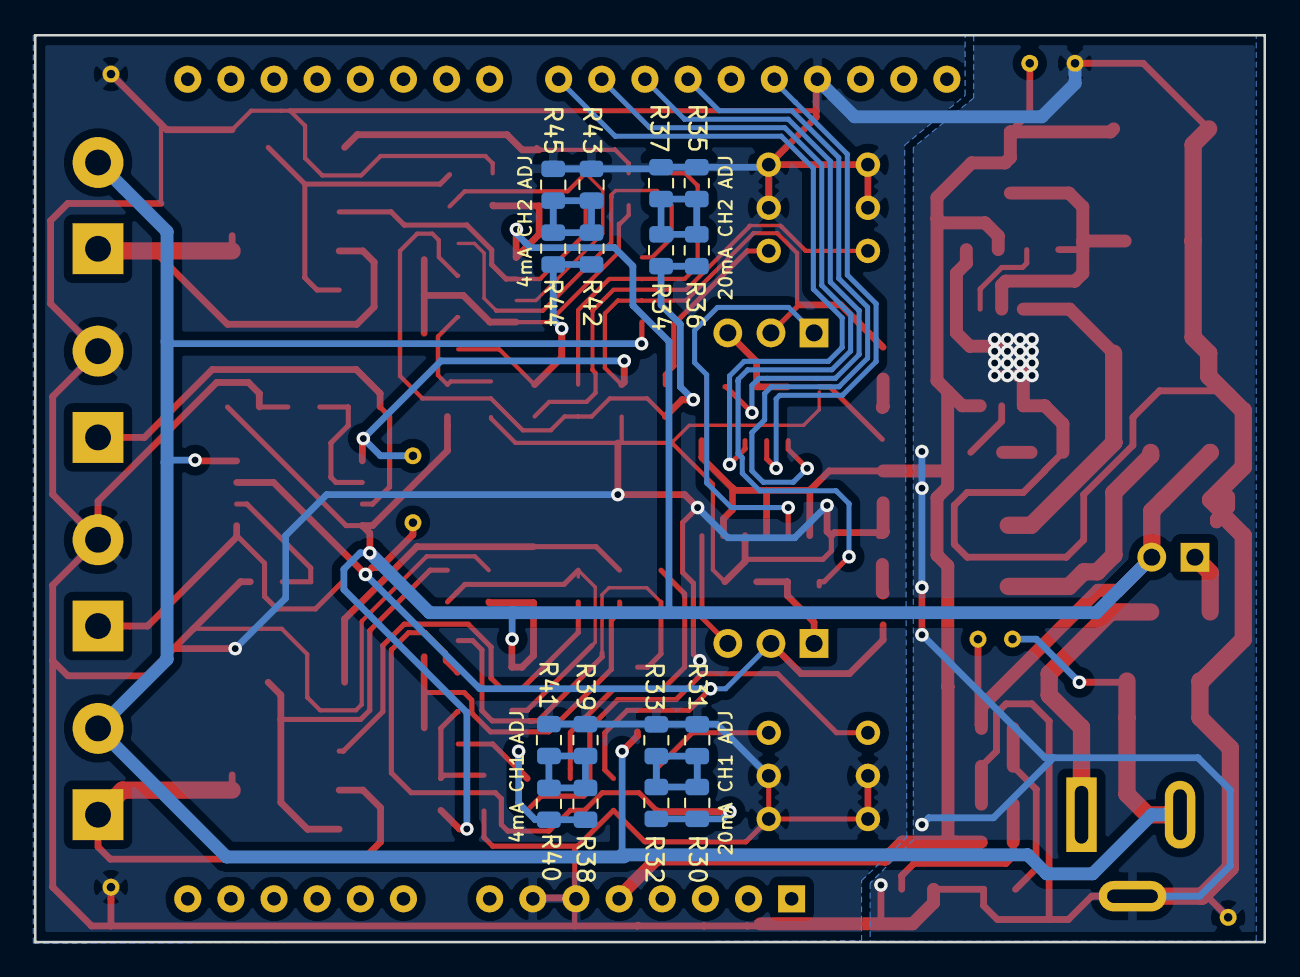
[picture p4: board 420-transmitter.kicad_pcb from below]

Board: 2 copper layers, 72.4 x 53.4 mm, 109 parts (17 on the bottom side), 61 nets.
